Hridhay08/fm-receiver/physical_demo/front_side.jpg

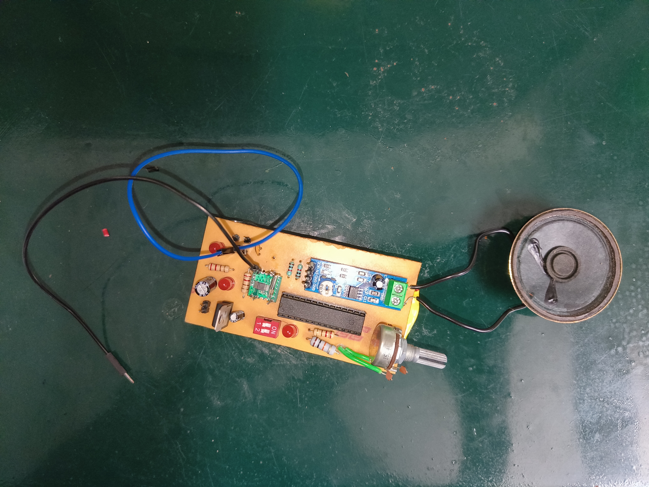
physical_demo/front_side.jpg
