Hridhay08/fm-receiver/physical_demo/atmega328p_isp_arduino.jpg

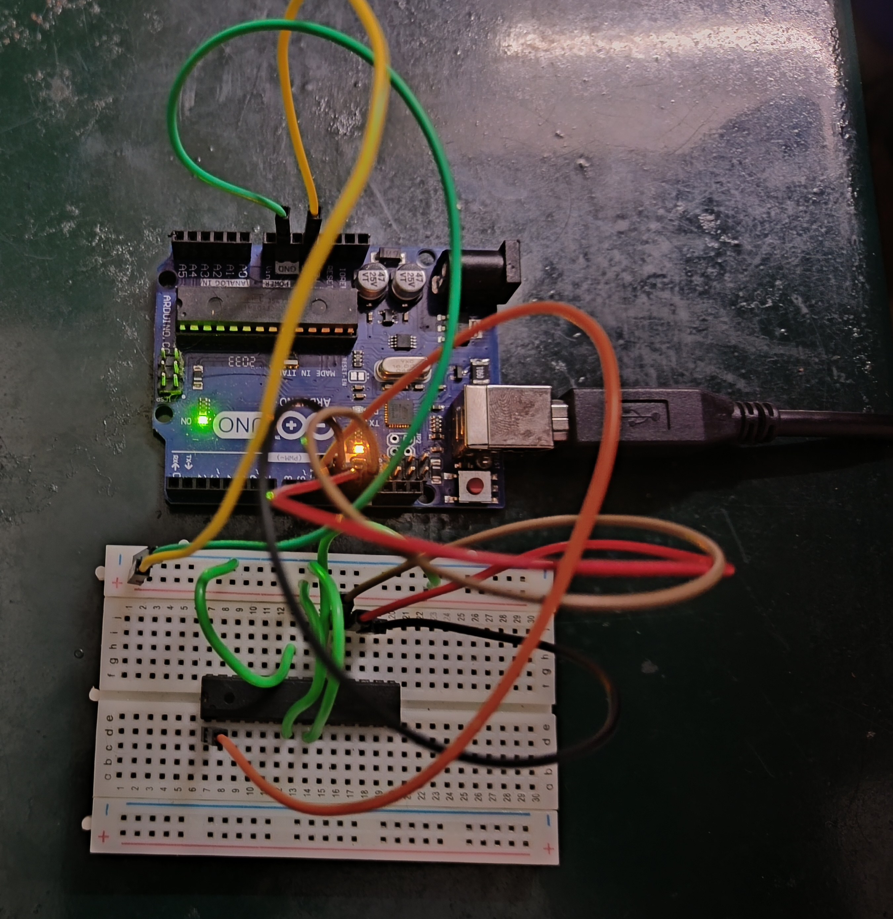
physical_demo/atmega328p_isp_arduino.jpg
