Hridhay08/fm-receiver/top_and_bottom.pdf

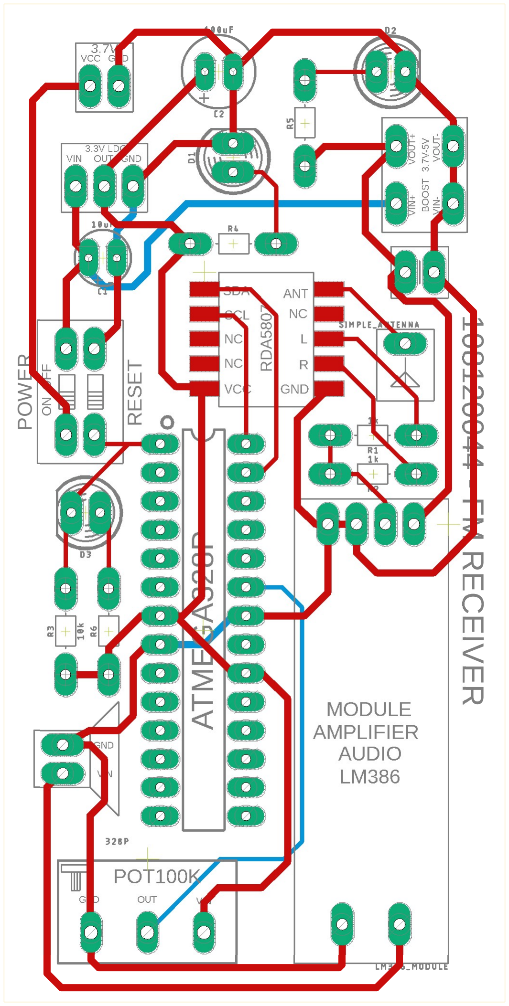
[picture p15: figure]
108120044 - FM RECEIVER; 3.7V ON OFF POWER
