Hridhay08/fm-receiver/pcb.png

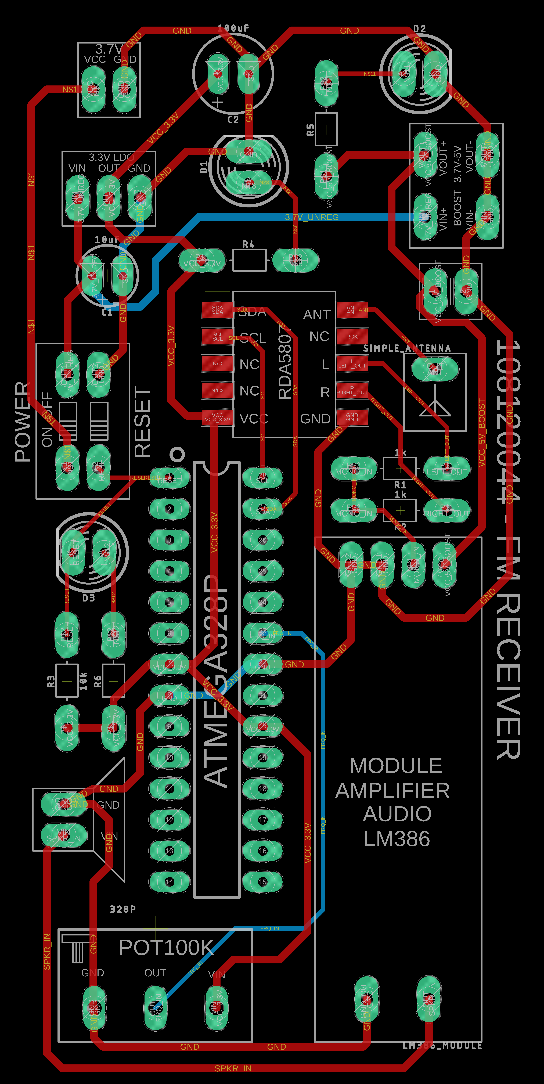
pcb.png
