Hridhay08/fm-receiver/physical_demo/back_side.jpg

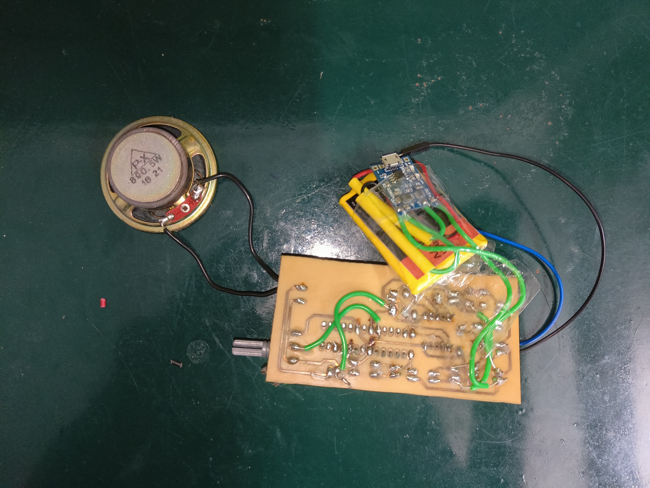
physical_demo/back_side.jpg
