Hridhay08/fm-receiver/top_black.pdf

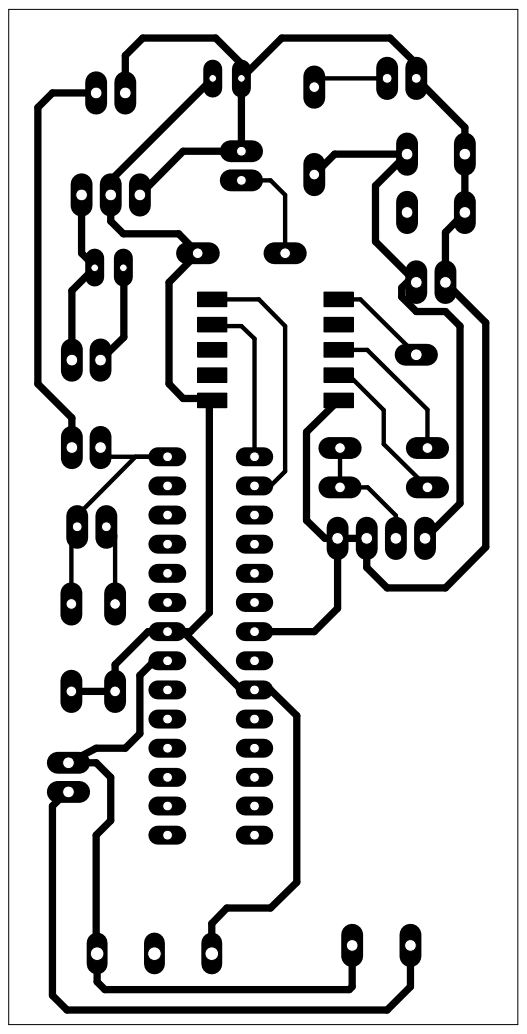
[picture p18: page 1]
