Hridhay08/fm-receiver/fm_receiver/fm_receiver_schematic.brd

## EAGLE design fm_receiver/fm_receiver_schematic.brd (2022-11-22)

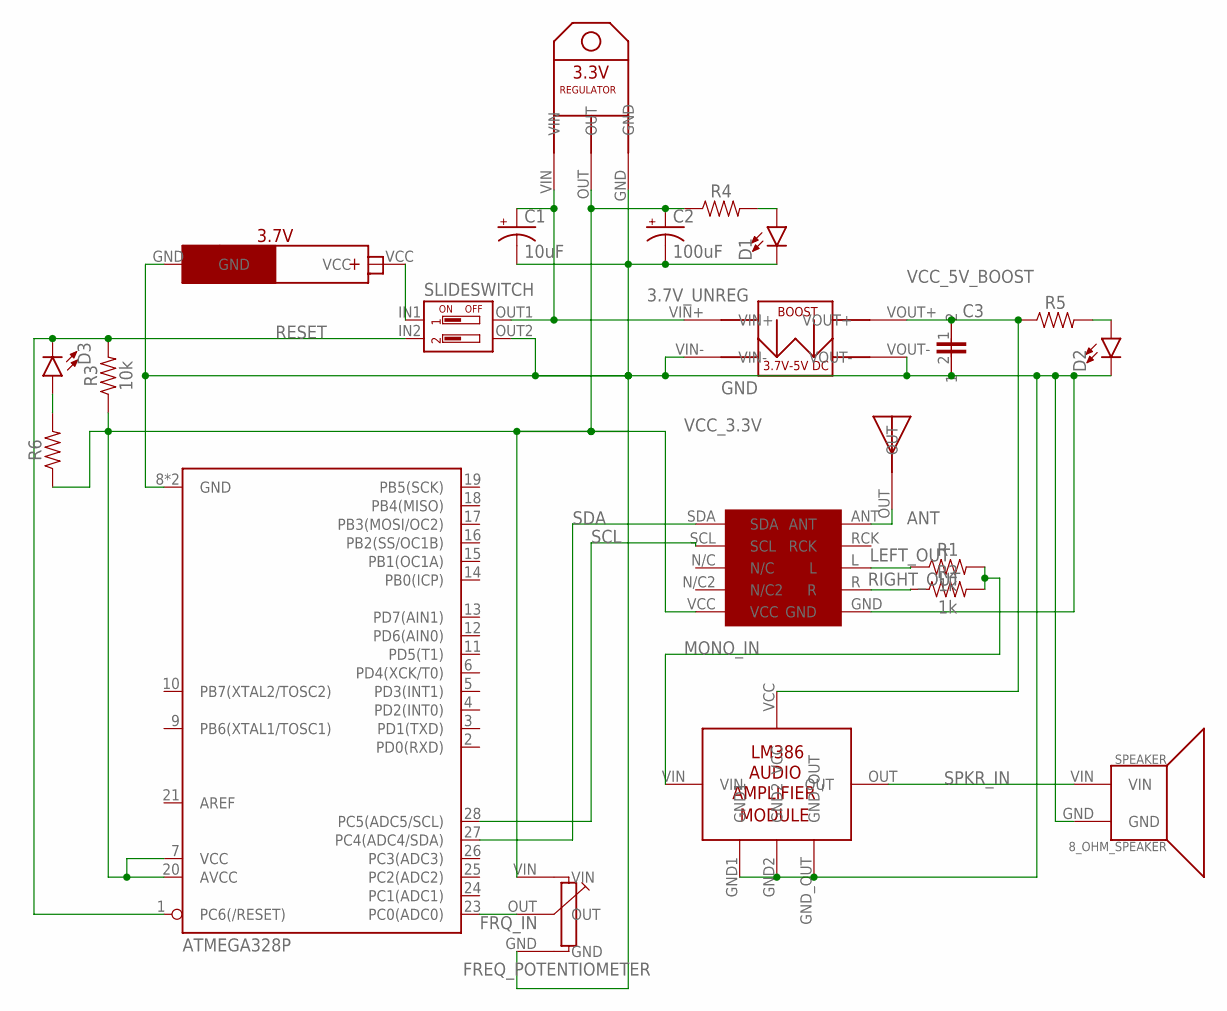
[picture p19: schematic fm_receiver_schematic.sch]

Parts:
3.3V_REGULATOR: LDO_REG_3.3V
3.7_5_BOOST: 3.7V_5V_BOOST_CONV
ANTENNA: SIMPLE_ANTENNA
ATMEGA328P: 328P; DIP28
C1: 10uF; CPOL-RADIAL-2.5MM-5MM
C2: 100uF; CPOL-RADIAL-2.5MM-6.5MM
C3: 0.1UF_CER_CAP
D1, D2, D3: LED5MM; LED_5MM
FM_RECEIVER: RDA
FREQ_POTENTIOMETER: POTENTIOMETER_LARGE
LM386_MODULE: LM386_AUDIO_AMP_MODULE
PWR_SUPPLY: 3.7V_PWR_DESIGNATOR
R1, R2: 1k; AXIAL-0.3
R3: 10k; AXIAL-0.3
R4, R5, R6: AXIAL-0.3
SLIDESWITCH: 2_WAY_DIP_PWR_RST_SLIDESWITCH
SPEAKER: 8_OHM_SPEAKER

Connections:
3.7V_UNREG: 3.3V_REGULATOR.VIN, 3.7_5_BOOST.VIN+, C1.1 (+), SLIDESWITCH.OUT1
ANT: ANTENNA.OUT, FM_RECEIVER.ANT
FRQ_IN: ATMEGA328P.23 (PC0(ADC0)), FREQ_POTENTIOMETER.OUT
GND: 3.3V_REGULATOR.GND, 3.7_5_BOOST.VIN-, 3.7_5_BOOST.VOUT-, ATMEGA328P.8 (GND), ATMEGA328P.22 (GND), C1.2 (-), C2.2 (-), C3.2, D1.K (C), D2.K (C), FM_RECEIVER.GND, FREQ_POTENTIOMETER.GND, LM386_MODULE.GND1, LM386_MODULE.GND2, LM386_MODULE.GND_OUT, PWR_SUPPLY.GND, SLIDESWITCH.OUT2, SPEAKER.GND
LEFT_OUT: FM_RECEIVER.L, R1.P$1 (1)
MONO_IN: LM386_MODULE.VIN, R1.P$2 (2), R2.P$2 (2)
unnamed: PWR_SUPPLY.VCC, SLIDESWITCH.IN1
unnamed: D1.A, R4.P$2 (2)
unnamed: D2.A, R5.P$2 (2)
unnamed: D3.A, R6.P$2 (2)
RESET: ATMEGA328P.1 (PC6(/RESET)), D3.K (C), R3.P$2 (2), SLIDESWITCH.IN2
RIGHT_OUT: FM_RECEIVER.R, R2.P$1 (1)
SCL: ATMEGA328P.28 (PC5(ADC5/SCL)), FM_RECEIVER.SCL
SDA: ATMEGA328P.27 (PC4(ADC4/SDA)), FM_RECEIVER.SDA
SPKR_IN: LM386_MODULE.OUT, SPEAKER.VIN
VCC_3.3V: 3.3V_REGULATOR.OUT, ATMEGA328P.7 (VCC), ATMEGA328P.20 (AVCC), C2.1 (+), FM_RECEIVER.VCC, FREQ_POTENTIOMETER.VIN, R3.P$1 (1), R4.P$1 (1), R6.P$1 (1)
VCC_5V_BOOST: 3.7_5_BOOST.VOUT+, C3.1, LM386_MODULE.VCC, R5.P$1 (1)

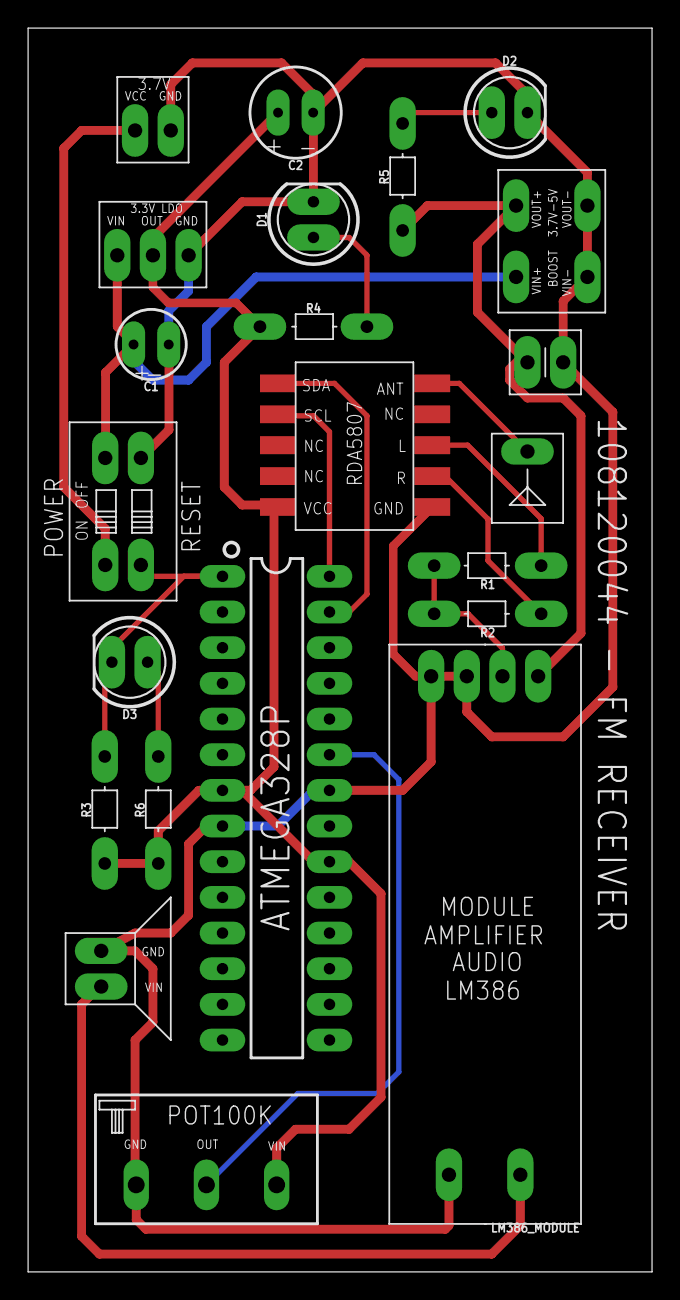
[picture p20: board fm_receiver_schematic.brd from above]

Board: 2 copper layers, 44.4 x 88.6 mm, 22 parts (0 on the bottom side), 17 nets.
