Hridhay08/fm-receiver/bare_bones_arduino_pcb_test/barebonesarduino.brd

## EAGLE design bare_bones_arduino_pcb_test/barebonesarduino.brd (2022-11-18)

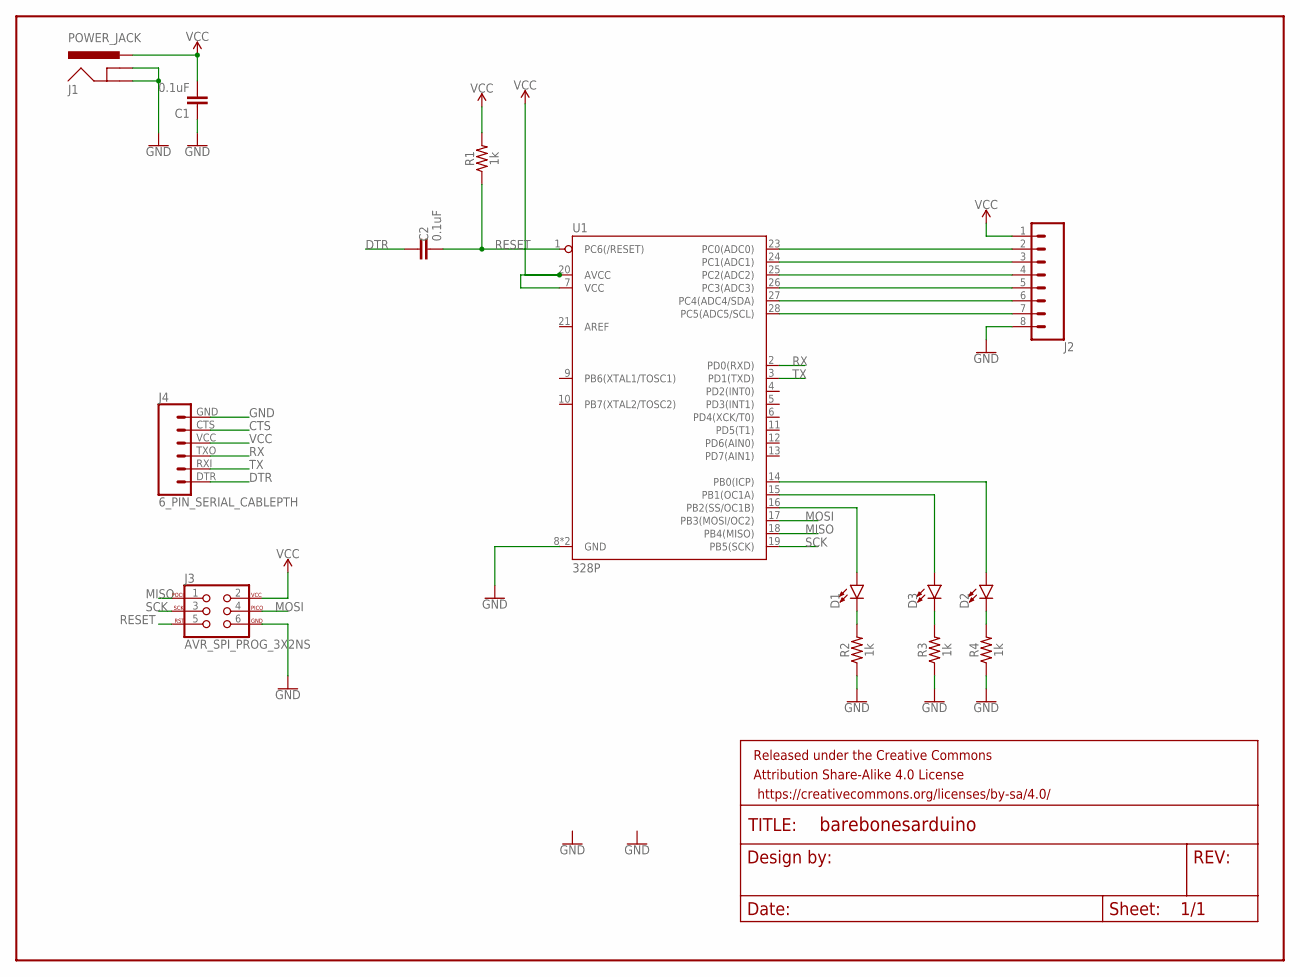
[picture p21: schematic barebonesarduino.sch]

Parts:
C1, C2: 0.1uF; CAP-PTH-SMALL-KIT
D1, D2, D3: LED5MM; LED_5MM
FRAME1: FRAME-LETTER; CREATIVE_COMMONS
J1: POWER_JACK; POWER_JACK_PTH
J2: CONN_08"; 1X08
J3: AVR_SPI_PROG_3X2NS; 2X3-NS
J4: 6_PIN_SERIAL_CABLEPTH; FTDI_BASIC
R1, R2, R3, R4: 1k; AXIAL-0.1-KIT
U1: 328P; DIP28

Connections:
CTS: J4.CTS (5)
DTR: C2.1, J4.DTR (1)
GND: C1.1, J1.GND, J1.GNDBREAK, J2.8, J3.6, J4.GND (6), R2.P$1 (1), R3.P$1 (1), R4.P$1 (1), U1.8 (GND), U1.22 (GND)
MISO: J3.1, U1.18 (PB4(MISO))
MOSI: J3.4, U1.17 (PB3(MOSI/OC2))
unnamed: J2.2, U1.23 (PC0(ADC0))
unnamed: D1.A, U1.16 (PB2(SS/OC1B))
unnamed: D3.A, U1.15 (PB1(OC1A))
unnamed: D2.A, U1.14 (PB0(ICP))
unnamed: D1.K (C), R2.P$2 (2)
unnamed: D3.K (C), R3.P$2 (2)
unnamed: D2.K (C), R4.P$2 (2)
unnamed: J2.7, U1.28 (PC5(ADC5/SCL))
unnamed: J2.6, U1.27 (PC4(ADC4/SDA))
unnamed: J2.5, U1.26 (PC3(ADC3))
unnamed: J2.4, U1.25 (PC2(ADC2))
unnamed: J2.3, U1.24 (PC1(ADC1))
RESET: C2.2, J3.5, R1.P$1 (1), U1.1 (PC6(/RESET))
RX: J4.TXO (3), U1.2 (PD0(RXD))
SCK: J3.3, U1.19 (PB5(SCK))
TX: J4.RXI (2), U1.3 (PD1(TXD))
VCC: C1.2, J1.PWR, J2.1, J3.2, J4.VCC (4), R1.P$2 (2), U1.7 (VCC), U1.20 (AVCC)

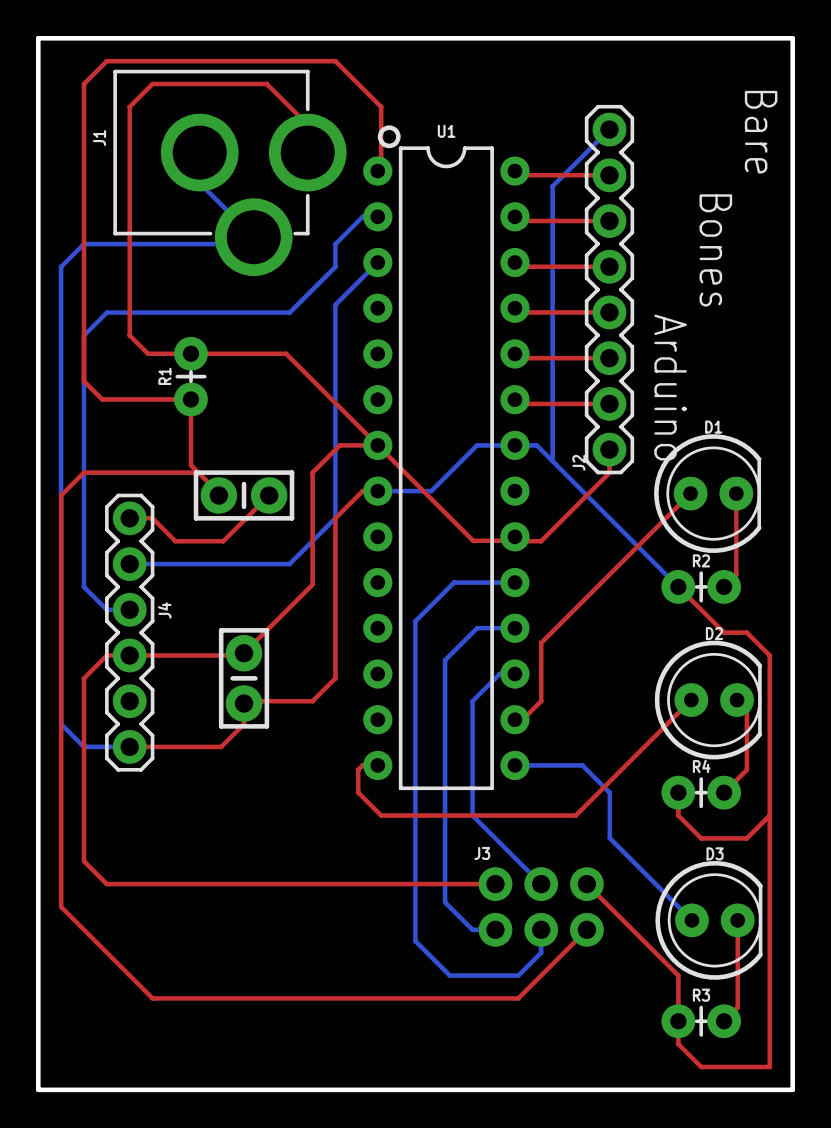
[picture p22: board barebonesarduino.brd from above]

Board: 2 copper layers, 41.9 x 58.4 mm, 15 parts (0 on the bottom side), 21 nets.
