Hridhay08/fm-receiver/speaker_arduino_test/speaker_output2/speaker_output2.ino

#include <Arduino.h>

#include "AudioFileSourcePROGMEM.h"
#include "AudioGeneratorWAV.h"
#include "AudioOutputI2SNoDAC.h"

// VIOLA sample taken from https://ccrma.stanford.edu/~jos/pasp/Sound_Examples.html
#include "viola.h"

AudioGeneratorWAV *wav;
AudioFileSourcePROGMEM *file;
AudioOutputI2SNoDAC *out;

void setup()
{
  Serial.begin(115200);
  delay(1000);
  Serial.printf("WAV start\n");

  audioLogger = &Serial;
  file = new AudioFileSourcePROGMEM( viola, sizeof(viola) );
  out = new AudioOutputI2SNoDAC();
  wav = new AudioGeneratorWAV();
  wav->begin(file, out);
}

void loop()
{
  if (wav->isRunning()) {
    if (!wav->loop()) wav->stop();
  } else {
    Serial.printf("WAV done\n");
    delay(1000);
    audioLogger = &Serial;
    file = new AudioFileSourcePROGMEM( viola, sizeof(viola) );
    out = new AudioOutputI2SNoDAC();
    wav = new AudioGeneratorWAV();
    wav->begin(file, out);
  }
}
