Hridhay08/fm-receiver/(commit log)

2022-11-19 changed round solder pads to long pads, and rerouted traces accordingly to prevent DRC errors
    [fm_receiver_schematic.brd, fm_receiver_schematic.sch]
2022-11-20 modified gerbers to reflect changed solder pads
2022-11-22 connected crucial GND terminal of RDA5807 to GND net, which was previously missed
    [fm_receiver_schematic.brd, fm_receiver_schematic.sch]
2022-12-12 generating pcb mask, new code and modified existing code for the atmega program, and other supplementary programs
